Stary2001/n64/hardware/0.2/n64.kicad_pcb

## KiCad design hardware/0.2/n64.kicad_pcb (2020-04-22)

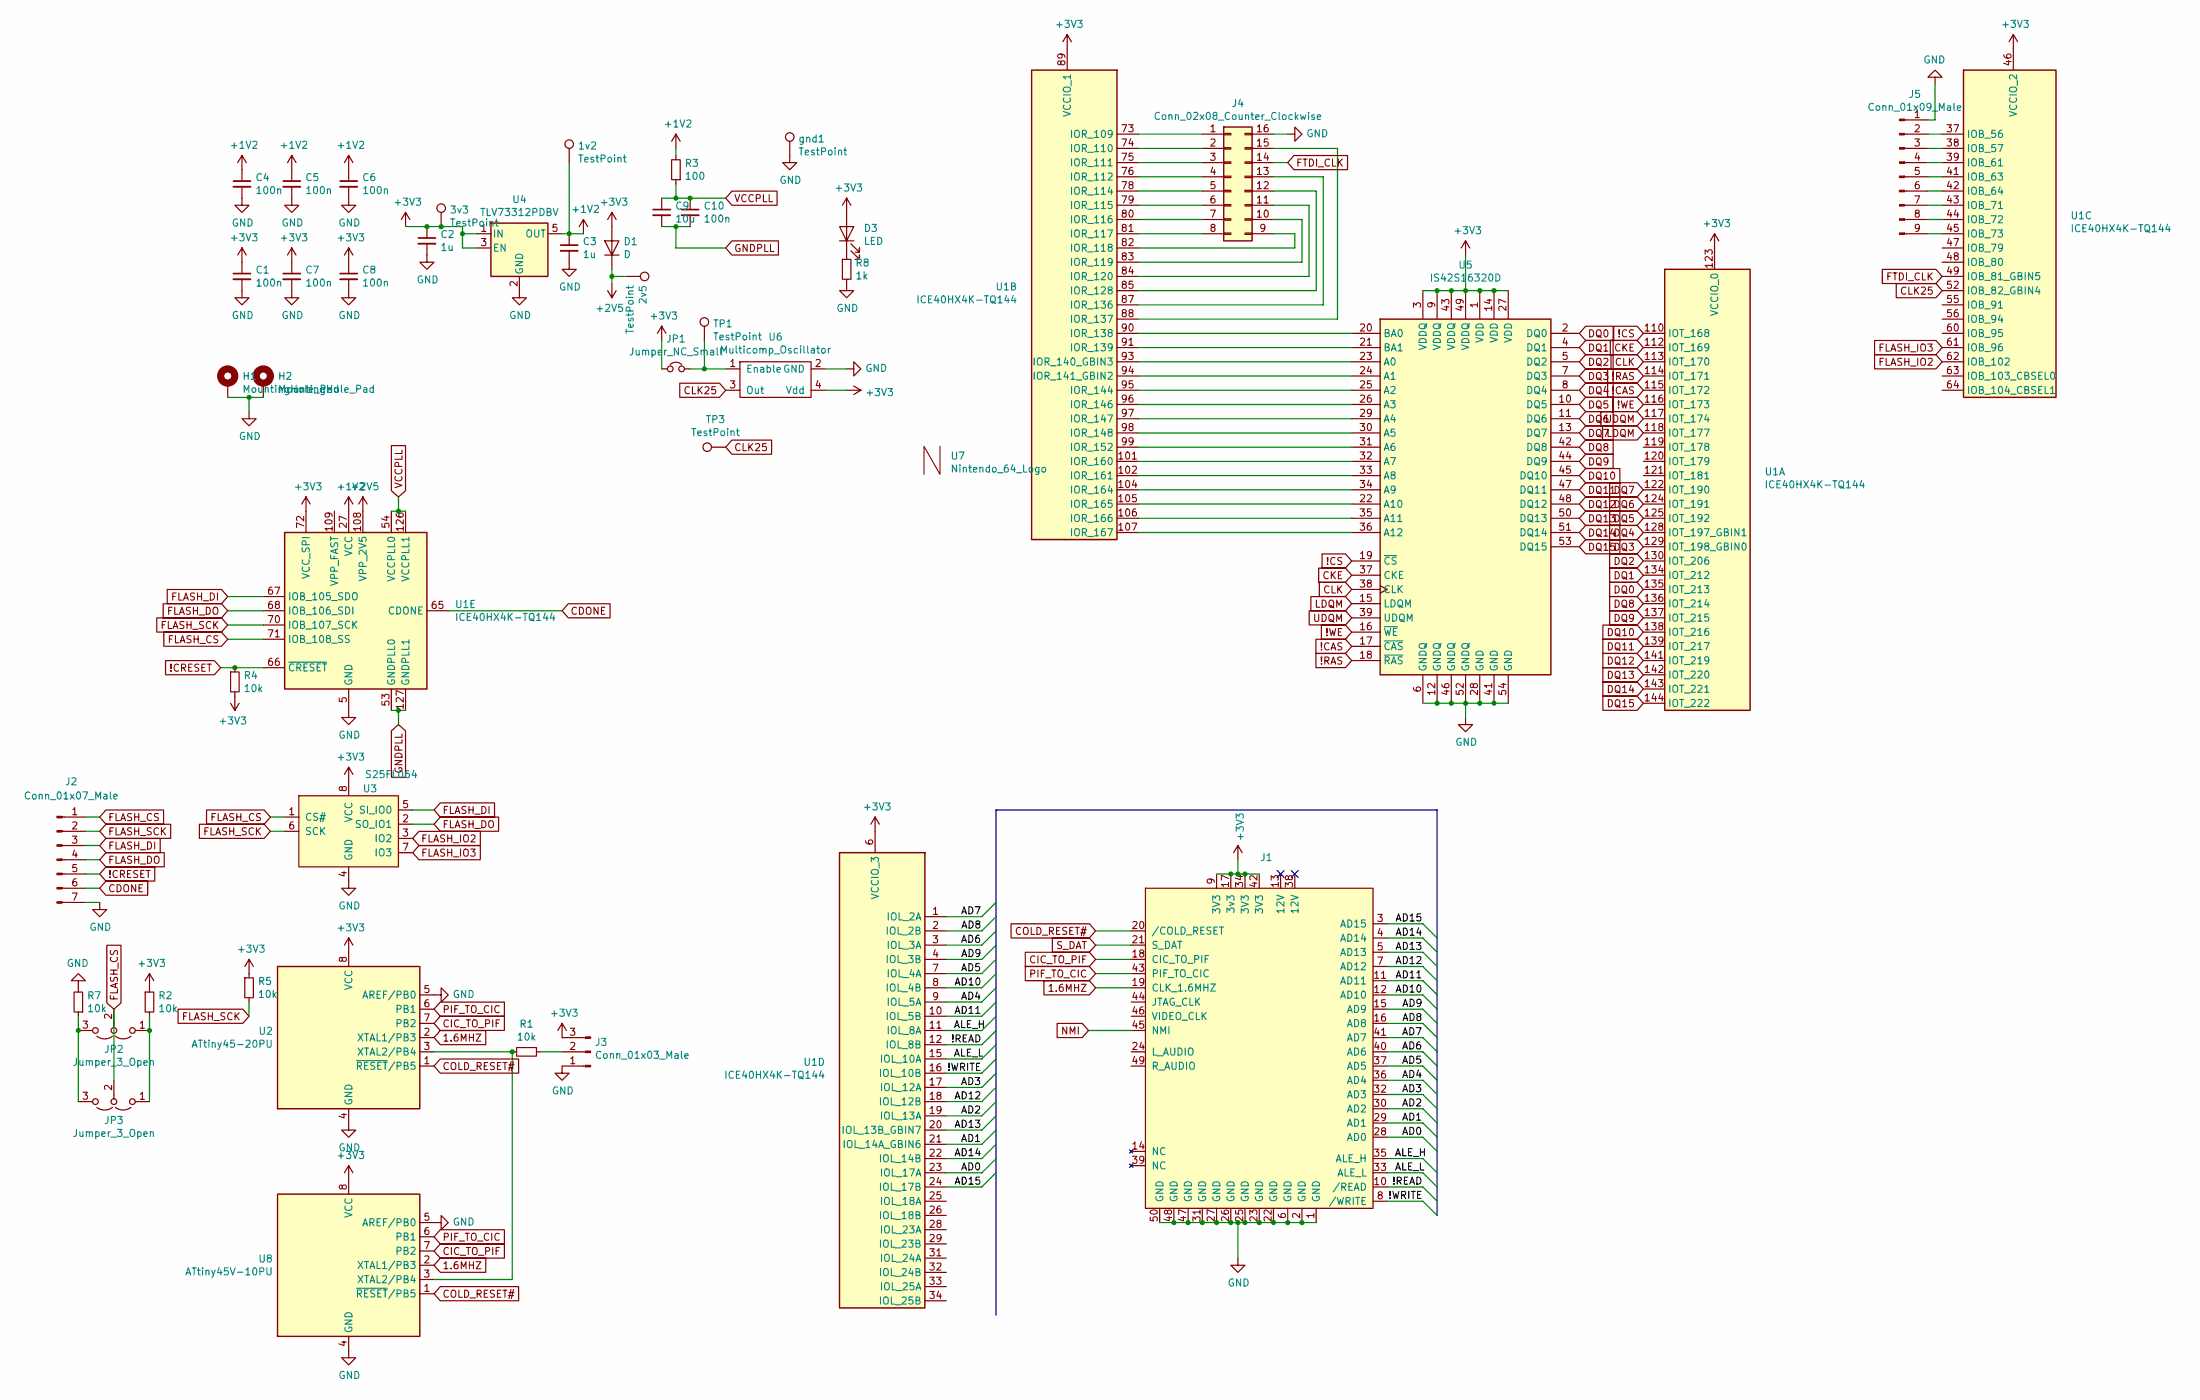
[picture p1: schematic n64.sch]

Parts:
1v2, 2v5, 3v3: TestPoint; TestPoint_Pad_D2.5mm
C1, C4, C5, C6, C7, C8, C10: 100n; R_0603_1608Metric_Pad1.05x0.95mm_HandSolder
C2, C3: 1u; R_0603_1608Metric_Pad1.05x0.95mm_HandSolder
C9: 10u; R_0603_1608Metric_Pad1.05x0.95mm_HandSolder
D1: D; D_SOD-123
D3: LED; LED_0603_1608Metric_Pad1.05x0.95mm_HandSolder
H1, H2: MountingHole_Pad; MountingHole_2.7mm_M2.5_Pad
J1: Nintendo_64_Cartridge
J2: Conn_01x07_Male; PinHeader_1x07_P2.54mm_Vertical
J3: Conn_01x03_Male; PinHeader_1x03_P2.54mm_Vertical
J4: Conn_02x08_Counter_Clockwise; IDC-Header_2x08_P2.54mm_Vertical
J5: Conn_01x09_Male; PinHeader_1x09_P2.54mm_Vertical
JP1: Jumper_NC_Small; SolderJumper-2_P1.3mm_Bridged_RoundedPad1.0x1.5mm
JP2: Jumper_3_Open; PinHeader_1x03_P2.54mm_Vertical
JP3: Jumper_3_Open; SolderJumper-3_P1.3mm_Open_Pad1.0x1.5mm_NumberLabels
R1, R2, R4, R5, R7: 10k; R_0603_1608Metric_Pad1.05x0.95mm_HandSolder
R3: 100; R_0603_1608Metric_Pad1.05x0.95mm_HandSolder
R8: 1k; R_0603_1608Metric_Pad1.05x0.95mm_HandSolder
TP1, TP3: TestPoint; TestPoint_Pad_D1.5mm
U1: ICE40HX4K-TQ144; TQFP-144_20x20mm_P0.5mm
U2: ATtiny45-20PU; DIP-8_W7.62mm
U3: S25FL064; SOIC-8_5.23x5.23mm_P1.27mm
U4: TLV73312PDBV; SOT-23-5
U5: IS42S16320D; TSOP-II-54_22.2x10.16mm_P0.8mm
U6: Multicomp_Oscillator; Oscillator_SMD_Abracon_ASE-4Pin_3.2x2.5mm
U7: Nintendo_64_Logo
U8: ATtiny45V-10PU; SOIC-8_5.23x5.23mm_P1.27mm
gnd1: TestPoint; TestPoint_Pad_D2.5mm

Connections:
1.6MHZ: J1.19 (CLK_1.6MHZ), U2.2 (XTAL1/PB3), U8.2 (XTAL1/PB3)
!CAS: U1.115 (IOT_172), U5.17 (~CAS)
!CRESET: J2.5, R4.1, U1.66 (~CRESET)
!CS: U1.110 (IOT_168), U5.19 (~CS)
!RAS: U1.114 (IOT_171), U5.18 (~RAS)
!WE: U1.116 (IOT_173), U5.16 (~WE)
+1V2: 1v2.1, C3.1, C4.1, C5.1, C6.1, R3.2, U1.27 (VCC), U1.40 (VCC), U1.92 (VCC), U1.111 (VCC), U4.5 (OUT)
+2V5: 2v5.1, D1.1 (K), U1.108 (VPP_2V5)
+3V3: 3v3.1, C1.1, C2.1, C7.1, C8.1, D1.2 (A), D3.2 (A), J1.9 (3V3), J1.17 (3v3), J1.34 (3V3), J1.42 (3V3), J3.3, JP1.1, R2.1, R4.2, R5.1, U1.6 (VCCIO_3), U1.30 (VCCIO_3), U1.46 (VCCIO_2), U1.57 (VCCIO_2), U1.72 (VCC_SPI), U1.89 (VCCIO_1), U1.100 (VCCIO_1), U1.123 (VCCIO_0), U1.131 (VCCIO_0), U2.8 (VCC), U3.8 (VCC), U4.1 (IN), U4.3 (EN), U5.1 (VDD), U5.3 (VDDQ), U5.9 (VDDQ), U5.14 (VDD), U5.27 (VDD), U5.43 (VDDQ), U5.49 (VDDQ), U6.4 (Vdd), U8.8 (VCC)
/!READ: J1.10 (/READ), U1.12 (IOL_8B)
/!WRITE: J1.8 (/WRITE), U1.16 (IOL_10B)
/AD0: J1.28 (AD0), U1.23 (IOL_17A)
/AD1: J1.29 (AD1), U1.21 (IOL_14A_GBIN6)
/AD2: J1.30 (AD2), U1.19 (IOL_13A)
/AD3: J1.32 (AD3), U1.17 (IOL_12A)
/AD4: J1.36 (AD4), U1.9 (IOL_5A)
/AD5: J1.37 (AD5), U1.7 (IOL_4A)
/AD6: J1.40 (AD6), U1.3 (IOL_3A)
/AD7: J1.41 (AD7), U1.1 (IOL_2A)
/AD8: J1.16 (AD8), U1.2 (IOL_2B)
/AD9: J1.15 (AD9), U1.4 (IOL_3B)
/AD10: J1.12 (AD10), U1.8 (IOL_4B)
/AD11: J1.11 (AD11), U1.10 (IOL_5B)
/AD12: J1.7 (AD12), U1.18 (IOL_12B)
/AD13: J1.5 (AD13), U1.20 (IOL_13B_GBIN7)
/AD14: J1.4 (AD14), U1.22 (IOL_14B)
/AD15: J1.3 (AD15), U1.24 (IOL_17B)
/ALE_H: J1.35 (ALE_H), U1.11 (IOL_8A)
/ALE_L: J1.33 (ALE_L), U1.15 (IOL_10A)
CDONE: J2.6, U1.65 (CDONE)
CIC_TO_PIF: J1.18 (CIC_TO_PIF), U2.7 (PB2), U8.7 (PB2)
CKE: U1.112 (IOT_169), U5.37 (CKE)
CLK: U1.113 (IOT_170), U5.38 (CLK)
CLK25: TP3.1, U1.52 (IOB_82_GBIN4), U6.3 (Out)
COLD_RESET#: J1.20 (/COLD_RESET), U2.1 (~RESET~/PB5), U8.1 (~RESET~/PB5)
DQ0: U1.135 (IOT_213), U5.2 (DQ0)
DQ1: U1.134 (IOT_212), U5.4 (DQ1)
DQ2: U1.130 (IOT_206), U5.5 (DQ2)
DQ3: U1.129 (IOT_198_GBIN0), U5.7 (DQ3)
DQ4: U1.128 (IOT_197_GBIN1), U5.8 (DQ4)
DQ5: U1.125 (IOT_192), U5.10 (DQ5)
DQ6: U1.124 (IOT_191), U5.11 (DQ6)
DQ7: U1.122 (IOT_190), U5.13 (DQ7)
DQ8: U1.136 (IOT_214), U5.42 (DQ8)
DQ9: U1.137 (IOT_215), U5.44 (DQ9)
DQ10: U1.138 (IOT_216), U5.45 (DQ10)
DQ11: U1.139 (IOT_217), U5.47 (DQ11)
DQ12: U1.141 (IOT_219), U5.48 (DQ12)
DQ13: U1.142 (IOT_220), U5.50 (DQ13)
DQ14: U1.143 (IOT_221), U5.51 (DQ14)
DQ15: U1.144 (IOT_222), U5.53 (DQ15)
FLASH_CS: J2.1, JP2.2 (C), JP3.2 (C), U1.71 (IOB_108_SS), U3.1 (CS#)
FLASH_DI: J2.3, U1.67 (IOB_105_SDO), U3.5 (SI_IO0)
FLASH_DO: J2.4, U1.68 (IOB_106_SDI), U3.2 (SO_IO1)
FLASH_IO2: U1.62 (IOB_102), U3.3 (IO2)
FLASH_IO3: U1.61 (IOB_96), U3.7 (IO3)
FLASH_SCK: J2.2, R5.2, U1.70 (IOB_107_SCK), U3.6 (SCK)
FTDI_CLK: J4.14, U1.49 (IOB_81_GBIN5)
GND: C1.2, C2.2, C3.2, C4.2, C5.2, C6.2, C7.2, C8.2, H1.1, H2.1, J1.1 (GND), J1.2 (GND), J1.6 (GND), J1.22 (GND), J1.23 (GND), J1.25 (GND), J1.26 (GND), J1.27 (GND), J1.31 (GND), J1.47 (GND), J1.48 (GND), J1.50 (GND), J2.7, J3.1, J4.16, J5.1, R7.2, R8.2, U1.5 (GND), U1.13 (GND), U1.14 (GND), U1.59 (GND), U1.69 (GND), U1.86 (GND), U1.103 (GND), U1.132 (GND), U1.140 (GND), U2.4 (GND), U2.5 (AREF/PB0), U3.4 (GND), U4.2 (GND), U5.6 (GNDQ), U5.12 (GNDQ), U5.28 (GND), U5.41 (GND), U5.46 (GNDQ), U5.52 (GNDQ), U5.54 (GND), U6.2 (GND), U8.4 (GND), U8.5 (AREF/PB0), gnd1.1
GNDPLL: C9.2, C10.2, U1.53 (GNDPLL0), U1.127 (GNDPLL1)
LDQM: U1.118 (IOT_177), U5.15 (LDQM)
NMI: J1.45 (NMI)
unnamed: D3.1 (K), R8.1
unnamed: J3.2, R1.1
unnamed: J4.1, U1.73 (IOR_109)
unnamed: J4.2, U1.74 (IOR_110)
unnamed: J4.3, U1.75 (IOR_111)
unnamed: J4.4, U1.76 (IOR_112)
unnamed: J4.5, U1.78 (IOR_114)
unnamed: J4.6, U1.79 (IOR_115)
unnamed: J4.7, U1.80 (IOR_116)
unnamed: J4.8, U1.81 (IOR_117)
unnamed: J4.9, U1.82 (IOR_118)
unnamed: J4.10, U1.83 (IOR_119)
unnamed: J4.11, U1.84 (IOR_120)
unnamed: J4.12, U1.85 (IOR_128)
unnamed: J4.13, U1.87 (IOR_136)
unnamed: J4.15, U1.88 (IOR_137)
unnamed: J5.2, U1.37 (IOB_56)
unnamed: J5.3, U1.38 (IOB_57)
unnamed: J5.4, U1.39 (IOB_61)
unnamed: J5.5, U1.41 (IOB_63)
unnamed: J5.6, U1.42 (IOB_64)
unnamed: J5.7, U1.43 (IOB_71)
unnamed: J5.8, U1.44 (IOB_72)
unnamed: J5.9, U1.45 (IOB_73)
unnamed: JP1.2, TP1.1, U6.1 (Enable)
unnamed: JP2.1 (A), JP3.1 (A), R2.2
unnamed: JP2.3 (B), JP3.3 (B), R7.1
unnamed: R1.2, U2.3 (XTAL2/PB4), U8.3 (XTAL2/PB4)
unnamed: U1.90 (IOR_138), U5.20 (BA0)
unnamed: U1.91 (IOR_139), U5.21 (BA1)
unnamed: U1.93 (IOR_140_GBIN3), U5.23 (A0)
unnamed: U1.94 (IOR_141_GBIN2), U5.24 (A1)
unnamed: U1.95 (IOR_144), U5.25 (A2)
unnamed: U1.96 (IOR_146), U5.26 (A3)
unnamed: U1.97 (IOR_147), U5.29 (A4)
unnamed: U1.98 (IOR_148), U5.30 (A5)
unnamed: U1.99 (IOR_152), U5.31 (A6)
unnamed: U1.101 (IOR_160), U5.32 (A7)
unnamed: U1.102 (IOR_161), U5.33 (A8)
unnamed: U1.104 (IOR_164), U5.34 (A9)
unnamed: U1.105 (IOR_165), U5.22 (A10)
unnamed: U1.106 (IOR_166), U5.35 (A11)
unnamed: U1.107 (IOR_167), U5.36 (A12)
PIF_TO_CIC: J1.43 (PIF_TO_CIC), U2.6 (PB1), U8.6 (PB1)
S_DAT: J1.21 (S_DAT)
UDQM: U1.117 (IOT_174), U5.39 (UDQM)
VCCPLL: C9.1, C10.1, R3.1, U1.54 (VCCPLL0), U1.126 (VCCPLL1)

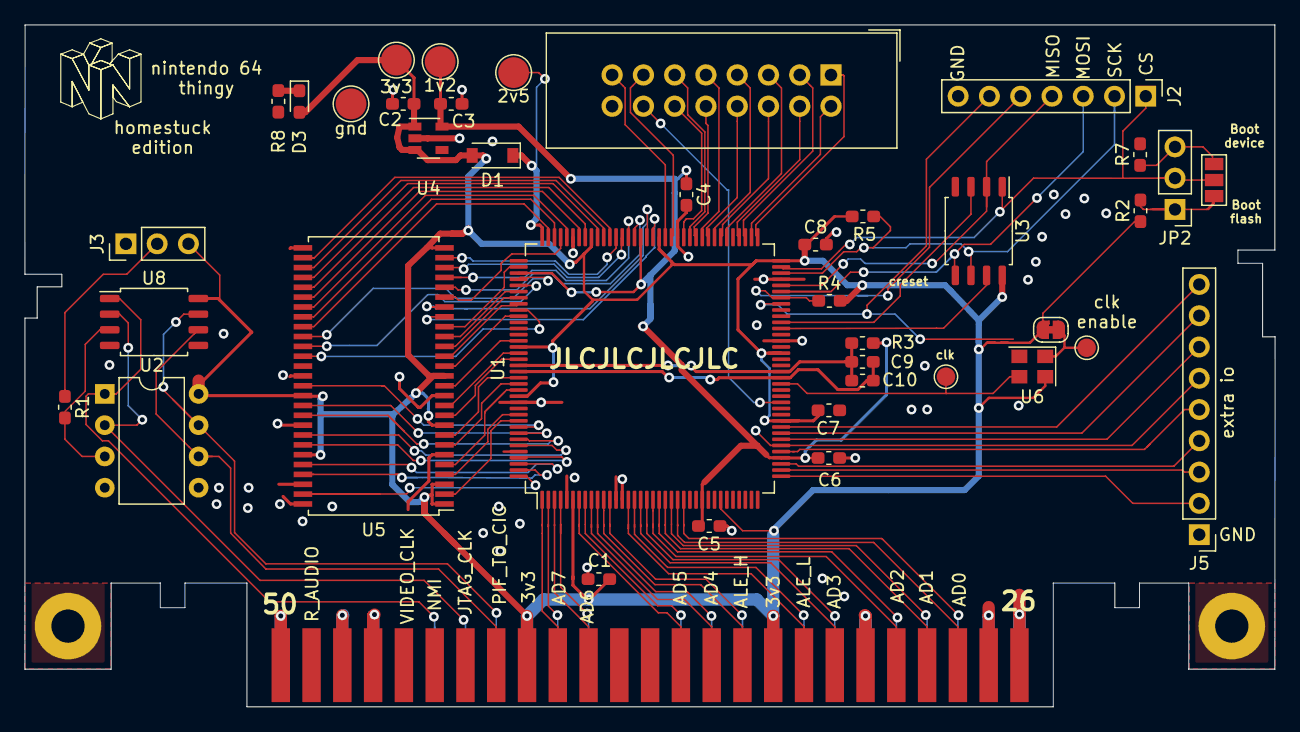
[picture p2: board n64.kicad_pcb from above]

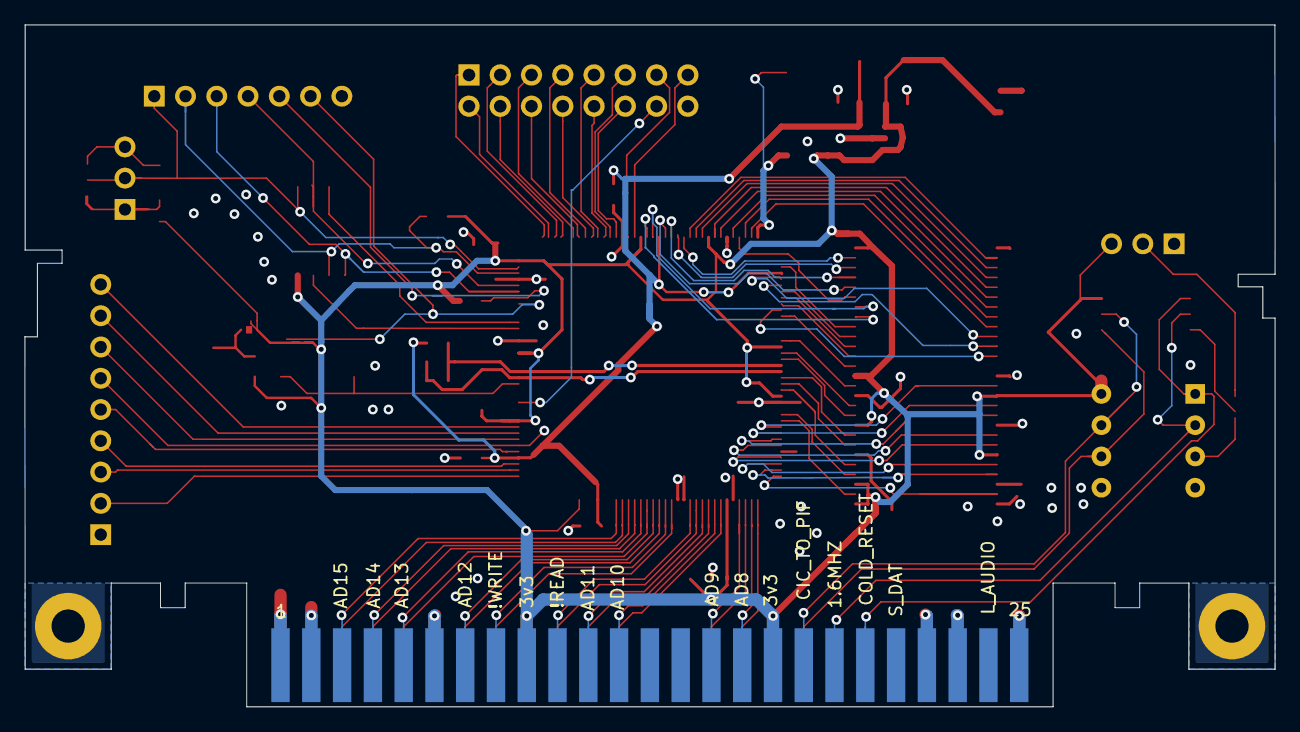
[picture p3: board n64.kicad_pcb from below]

Board: 2 copper layers, 101.5 x 55.4 mm, 43 parts (4 on the bottom side), 107 nets.
