Stary2001/n64/(commit log)

2020-04-04 Initial version??
    [n64.kicad_pcb, n64.sch]
2020-04-22 move to subdir
    [n64.kicad_pcb, n64.sch]
2020-04-22 some changes
    [n64.kicad_pcb, n64.sch]
